Groupe-Mecatronique-Mines-04/Orchestre/Archives/DocumentsGuitarElec/ArchitectureLiaisonsDePilotage_GuitarElec.docx

GuitarElec 2016 : Architecture des liaisons de pilotage des capteurs et actionneurs

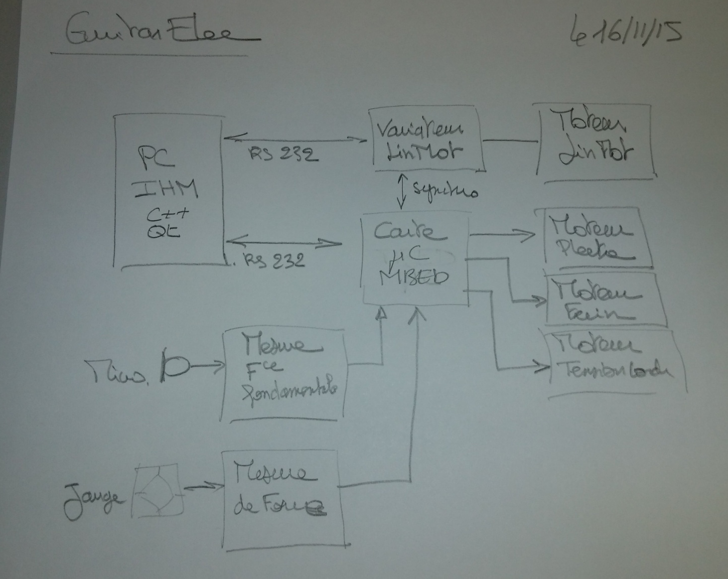
[picture p1: figure]

TAL220 10daN

Synchro ou non ?

?

Tension analogique ?

Micro type « humbucker »

USB/RS232

USB/RS232

Servomoteur Num

Dynamixel AX-12

Servomoteur Num

Dynamixel AX-12

Variateur SyRen10

Motoréducteur Crouset GDR1

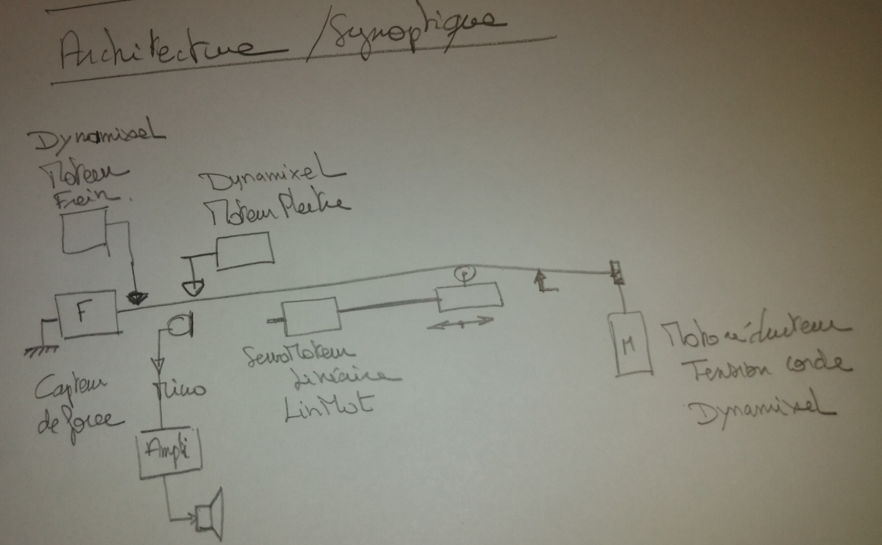
[picture p2: figure]
