Groupe-Mecatronique-Mines-04/Orchestre/Archives/DocumentsGuitarElec/Composants/MoteurLinMot/MoteurDejaAchetÇ.docx

LinMot

Le moteur :

Stator : PS01-37x120-C

Slider : PL01-20x800x720 720 mm est la longueur avec force maxi

Variateur : B1100-GP

Avec logiciel LinRS

Alim 72 volts 300 W

Modèle utilisé par les xMines en septembre, avec la flute, ce modèle sera utilisé au début pour prendre en main la programmation et pilotage du moteur

Stator : PS01-23x80-R

Slider : PL01-12x420x370 370 mm est la longueur avec force maxi

Même variateur, logiciel et alimentation
