Groupe-Mecatronique-Mines-04/Orchestre/Archives/DocumentsGuitarElec/TxEleves/Windchill/synthese mecatro.pptx

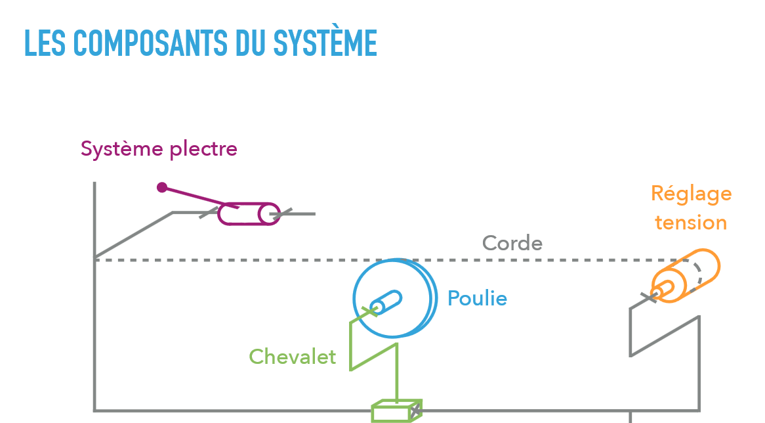
[picture p11: figure]
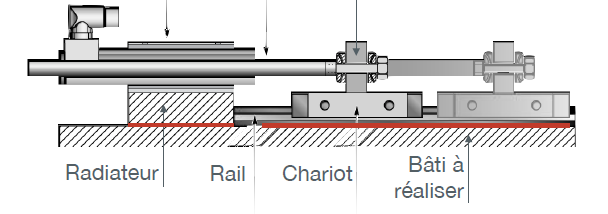
[picture p12: figure]

## Le système plectre

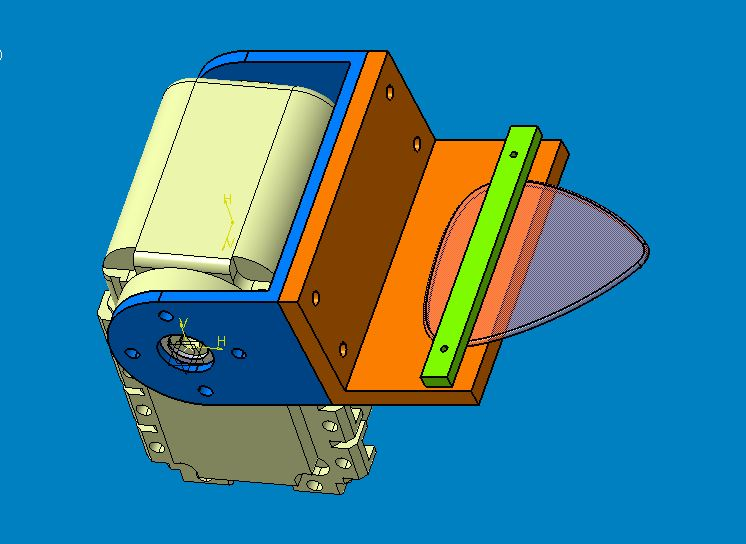
[picture p13: figure]

Plectre en position haute

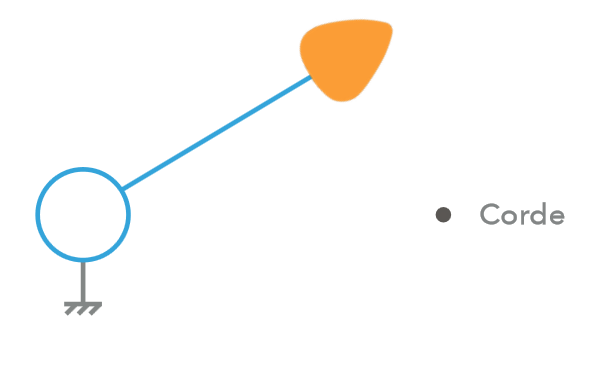
[picture p14: figure]

moteur rotatif

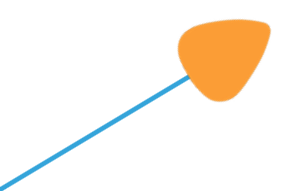
[picture p15: figure]

30 °

Plectre en position basse

Schéma du système plectre

Moteur : servo-moteur AX-12 de Robotis
Angle entre les deux positions du plectre : 30°

Poids (g) | 54.6
Dimensions (mm) | 32x50x40
Voltage (V) | 9
Couple (Nm) | ~ 1.52
Vitesse sans charge (rpm) | 59 ~ 1 tour/sec

## Le moteur linéaire et son guidage

Moteur linéaire : LinMot P01-37x120/580x660
Course max : 66 cm
Force max : 163 N
Vitesse max : 3,2 m/s
Courant : continu, 8,0 A max (72 VDC)
Stator : 21,6 cm, 0,740 kg
Slider : 80 cm, 1,762 kg
Système guidage :
- On fixe le stator au bâti avec le radiateur LinMot PF02-37x100 afin de travailler sur le guidage du moteur.
- La trajectoire du slider et donc le rail conduisant le chariot doivent être parfaitement parallèle au stator.

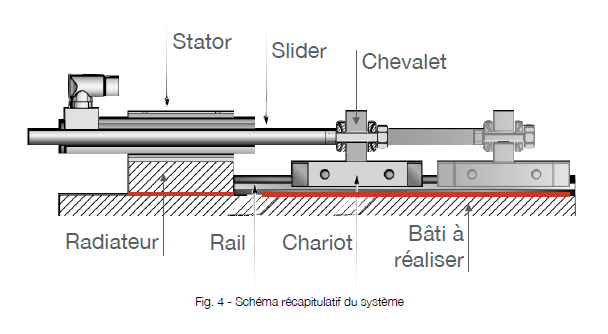
[picture p16: figure]

Schéma du moteur linéaire avec son guidage

## Le chevalet

Poulie

Ressort

Corde guitare

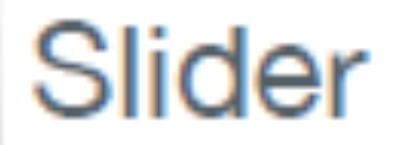
[picture p17: figure]

Il sera fixé au moteur linéaire et bouge linéairement lorsque celui-ci est actionné
Le contact avec la corde se fait par une poulie

## Le système tension de la corde

Utilisation d’une clé de guitare
Moteur : GDR1 courant continu + réducteur
Couple max : 1,2 Nm
Voltage : 12 V
Puissance nominale : 10 W
Vitesse max : 100 tr/min = 1,67 tr/s
Masse : 670 g
Tension à supporter : de l’ordre de 100 N
pour une tension moyenne de 100N, pouvoir la faire varier de 45 à 225 N
Asservissement en tension

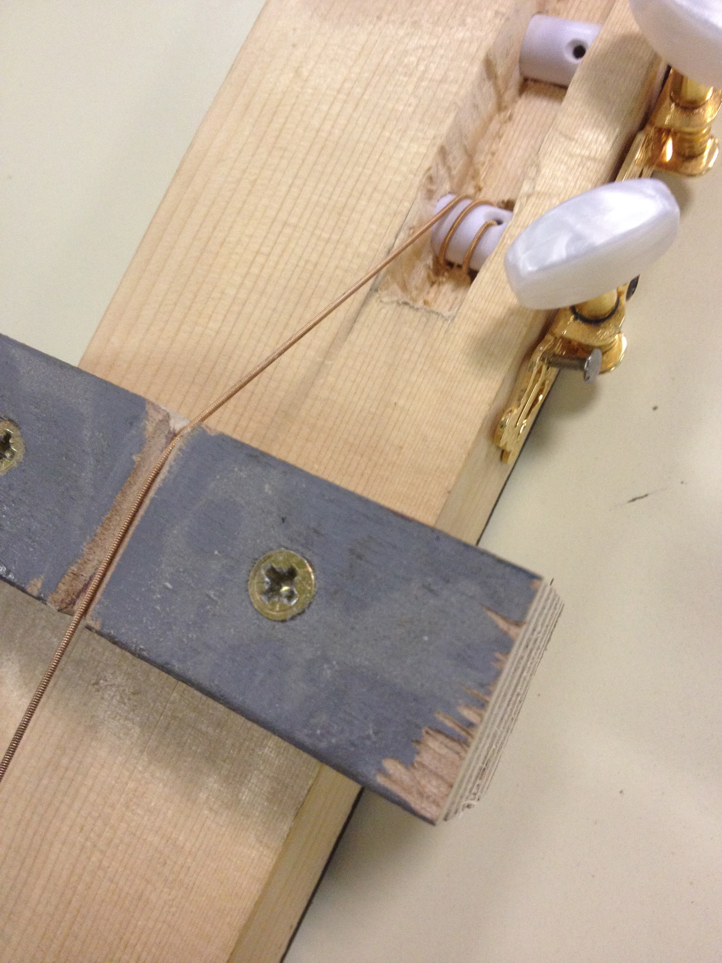
[picture p18: figure]

Le système tension sur la maquette de la guitare

## Les mesures du système

Moteur linéaire : 66 cm de mouvement
Longueur minimale de la corde utile : 10 cm
Longueur maximale : 76 cm

Disposition des différents système par rapport à la corde

Longueur utile de la corde, selon la position du chevalet

Point de fixation de la corde

Point de fixation de la corde

Système plectre

10 cm

Chevalet

Corde

Système Tension

Amplitude du chevalet : 66 cm

10 cm

## Les commandes du système

Un programme informatique doit être écrit pour :
- Créer une interface homme-machine
- A partir des commandes de l’utilisateur, envoyer des commandes aux différents moteurs du système pour exécuter la tâche demandée

Schéma du système électronique retenu de la guitare élec

Légende :

Programme

Commande

Carte Arduino

Moteur linéaire

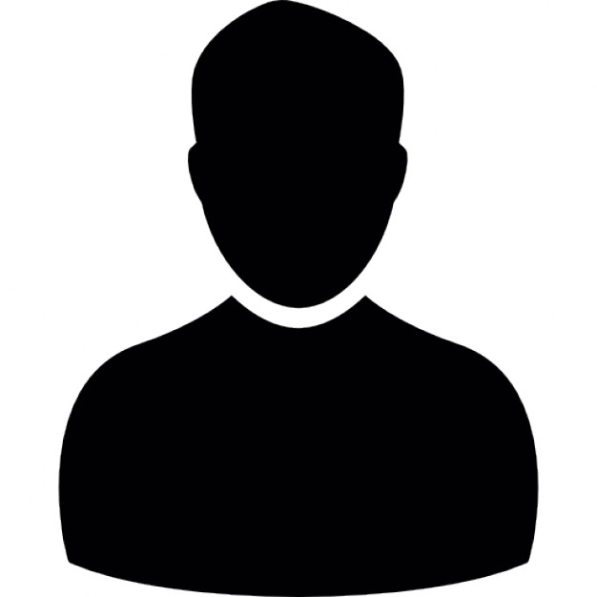
[picture p19: figure]

Moteur tension

Servo-moteur plectre
