Groupe-Mecatronique-Mines-04/Orchestre/Archives/DocumentsGuitarElec/TxEleves/Windchill/Sous-projets/Fixation de la corde/SYSTEME D’ASSERVISSEMENT DE LA CORDE DE GUITARE.docx

# SYSTEME D’ASSERVISSEMENT DE LA CORDE DE GUITARE

## PREMIÈRE ÉBAUCHE DU SYSTÈME

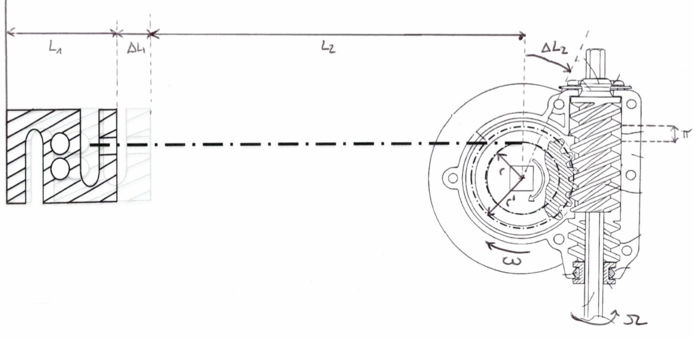
[picture p20: figure]

Motoréducteur et système de mise en tension

Corde de guitare

Capteur et jauge de déformation

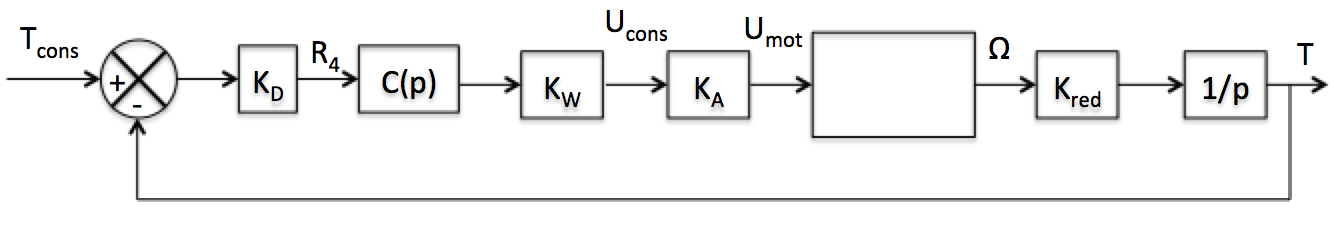
[picture p21: figure]

## MODÈLE D’ASSERVISSEMENT

A/(1+τp)

T

KD : coefficient de déformation de la jauge de déformation

C(p) : correcteur éventuel (dans une deuxième phase)

KW : amplification et filtrage, relation entre composants électroniques

KA : amplification du signal pour atteindre [-12V ;+12V]

On modélise le {moteur+variateur} par un premier ordre.

Kred : réducteur en sortie du moteur + pièce mécanique qui permet d’enrouler la corde

Problème :

1) savoir s’il y a besoin d’une première valeur test pour fixer l’origine des mesures.

2) Relation non linéaire entre la tension de la corde et la fréquence de vibration.

### CALCUL DES COÉfficients

KD : il faut le calculer avec la jauge de déformation achetée :

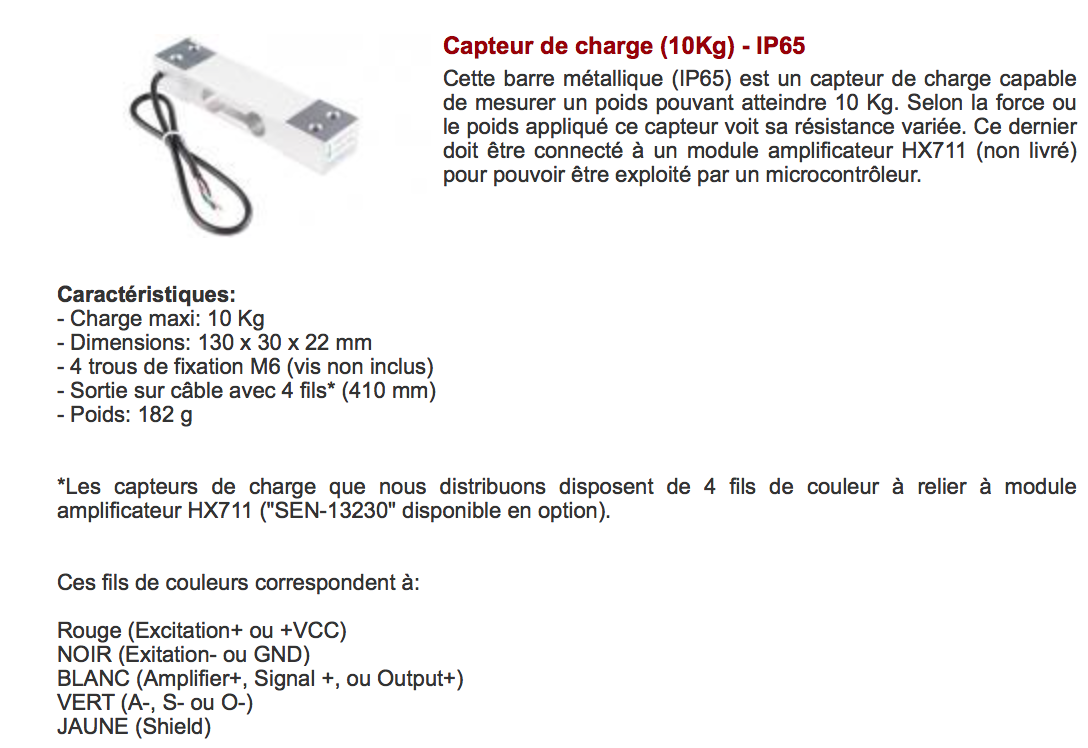
[picture p22: figure]

C(p) : ??? Intégrateur ? Proportionnel ? Dérivé ?

KW et KA : Le calcul se fait à l’aide du schéma électronique suivant :

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
U_3 =-(R_8)/(R_7)U_2 ; U_2 =(-(R_6)/(R_5))/(1+jR_6 Cω)U_1 ; U_1 =(U((R_2 R_4)/(R_2 +R_3)-(R_3)/(R_1 +R_2)))/(R_1 +R_4)

Sans doute plus intelligent de mesurer une tension différentielle et ne pas fixer la masse sur un pont de Weastone.

A et τ : À mesurer une fois qu’on a le moteur

Kred : fourni dans la documentation du moteur

## DIMENSIONNEMENT

On veut jouer environ 3 notes par seconde minimum → f = 3Hz et T=0,33s

L’amplitude de chargement de la corde est de 10kg. On suppose donc que dans le pire des cas on passe de 0kg à 10 kg en 0,33s, la vitesse de chargement est donc vs=30kg/s

Allongement max de la corde : 1cm, la vitesse d’allongement est donc au maximum de 2-3cm/s.
On considère que l’ordre de grandeur du diamètre d’enroulement est 0,5mm donc le périmètre appartient à [12mm ;19mm], il faut donc 1 à 2 tours par seconde. → N∈[60;120] Tr/min

Couple sans frottements en sortie du moteur : environ 100Nx3mm=0,3Nm

Coefficient de sécurité : 2-3 ?

En sortie du moteur, il nous faut une puissance de [10rad/s ;15rad/s]x0,3Nm=[3W-5W]

En supposant un rendement du réducteur d’environ 50%, on dimensionne le moteur à environ

6-10W
