Groupe-Mecatronique-Mines-04/Orchestre/Archives/DocumentsGuitarElec/TxEleves/Windchill/Livrables/01-livrable revue 1/Revue de projet 03_10_2015.pdf

# GUITAR ELEC

# REVUE DE PROJET

Le 03/11/2015

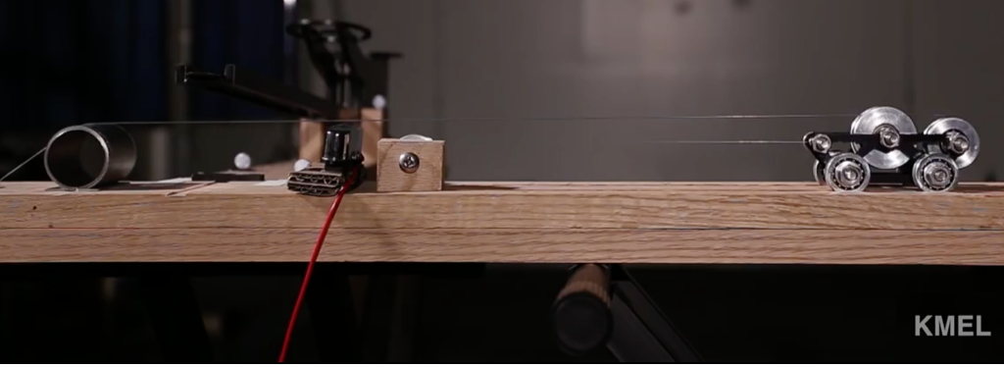
[picture p27: figure]

# LE PROJET KMEL

# L’INSPIRATION

# ANALYSE DU BESOIN

# DIAGRAMME BÊTE À CORNES

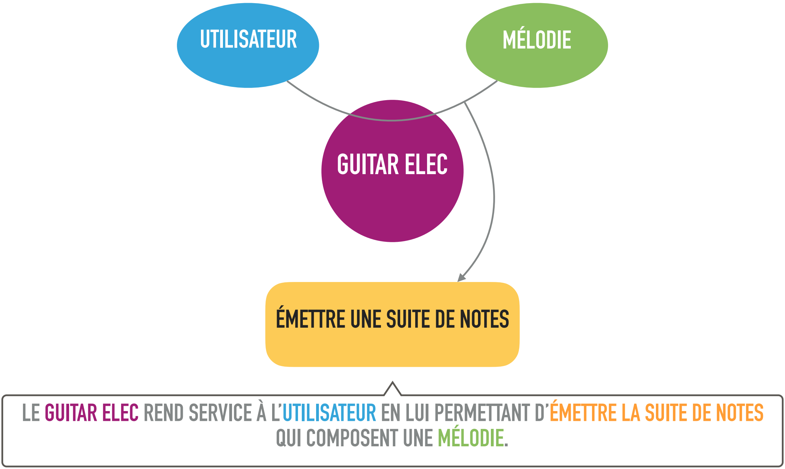
[picture p28: figure]
UTILISATEUR; MÉLODIE; GUITAR ELEC; ÉMETTRE UNE SUITE DE NOTES; QUI COMPOSENT UNE MÉLODIE.

# LE GUITAR ELEC REND SERVICE À L’UTILISATEUR EN LUI PERMETTANT D’ÉMETTRE LA SUITE DE NOTES

# SCHÉMA DU SYSTÈME

# LES COMPOSANTS DU SYSTÈME

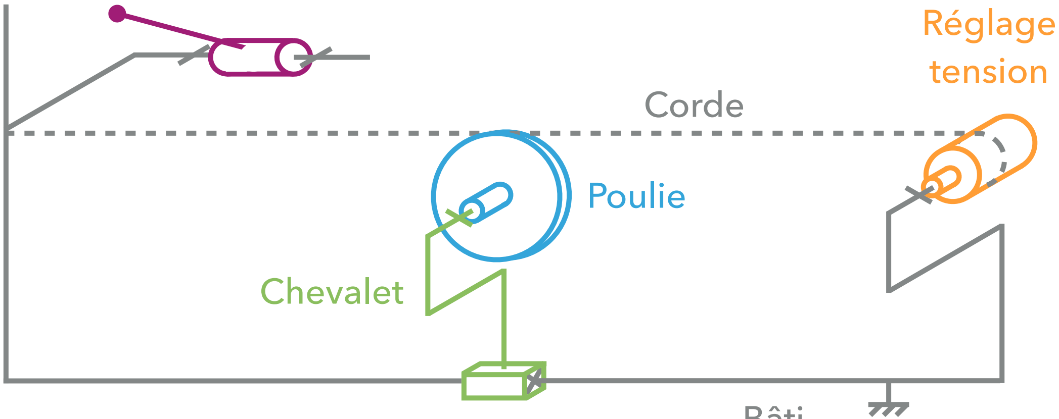
[picture p29: figure]
Corde; Chevalet; Réglage tension; Poulie

# Bâti

# Système plectre

# SCHÉMA DU SYSTÈME

# LES ACTIONNEURS DU SYSTÈME

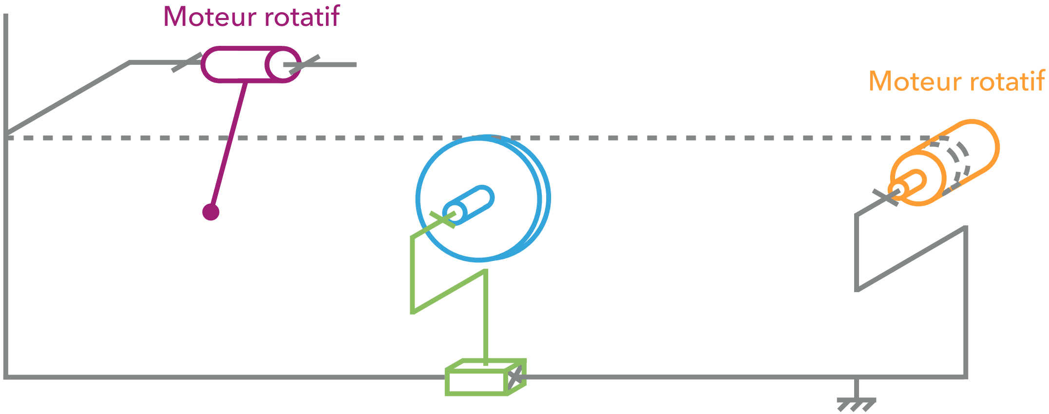
[picture p30: figure]
Moteur rotatif

# Moteur linéaire

# ANALYSE FONCTIONNELLE TECHNIQUE

# CHAÎNE D’INFORMATION ET D’ÉNERGIE

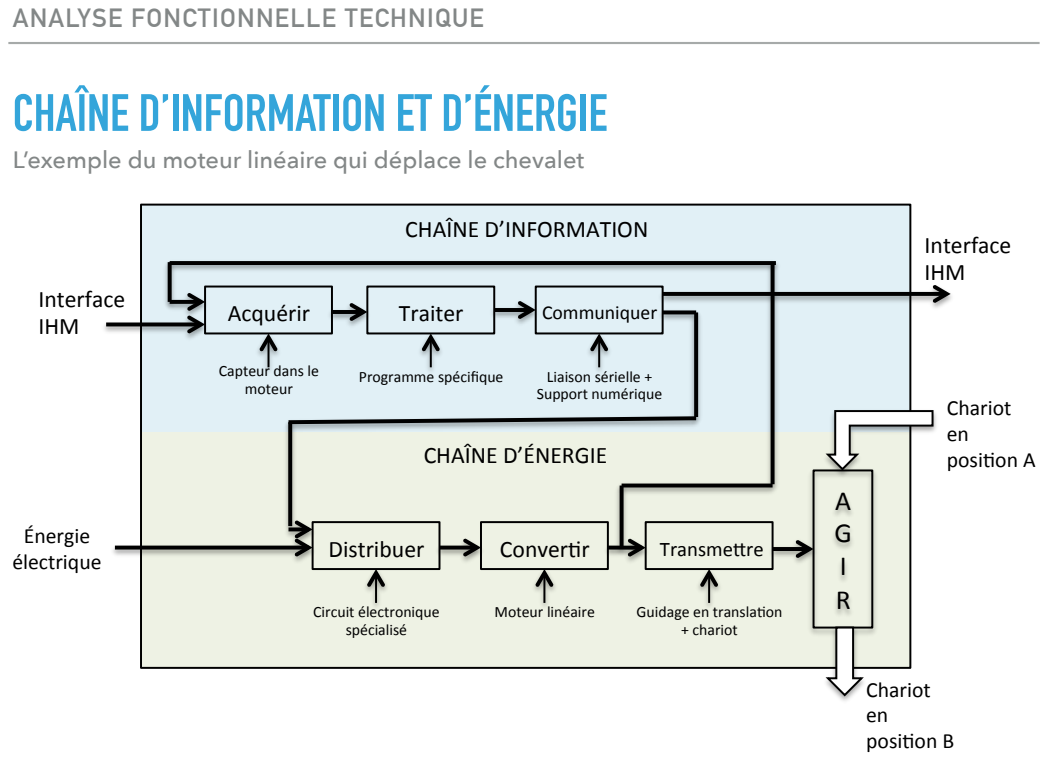
[picture p31: page 6]
Distribuer; Circuit électronique spécialisé; Conver4r; Moteur linéaire; Transme8re; Guidage en transla4on + chariot; Chariot en posi4on A; Chariot en posi4on B; CHAÎNE D’ÉNERGIE; CHAÎNE D’INFORMATION; Énergie électrique; Acquérir; Traiter; Programme spécifique; Communiquer; Liaison sérielle + Support numérique; Interface IHM

L’exemple du moteur linéaire qui déplace le chevalet

Capteur dans le
moteur

# DIAGRAMME FAST

# Permettre à l’utilisateur d’émettre la suite de notes composant une mélodie

FP1

# DIAGRAMME FAST

Permettre à
l’utilisateur
d’émettre la suite
de notes
composant une
mélodie

FP1

## FT11 Recevoir et traiter la commande de l’utilisateur

# Interface Homme Machine

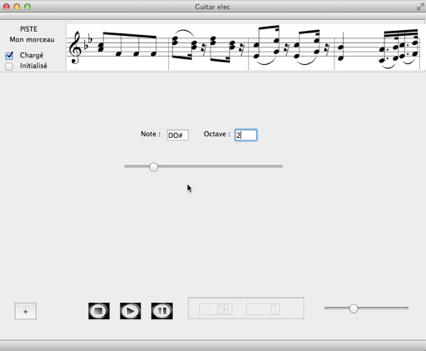
[picture p32: figure]

# DIAGRAMME FAST

Permettre à
l’utilisateur
d’émettre la suite
de notes
composant une
mélodie

FP1

# Interface Homme Machine

# Logiciel

# Optimisation du chemin en tension et déplacement du chevalet entre deux notes

## FT11 Recevoir et traiter la commande de l’utilisateur

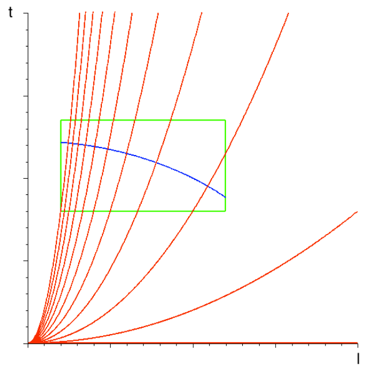
[picture p33: figure]
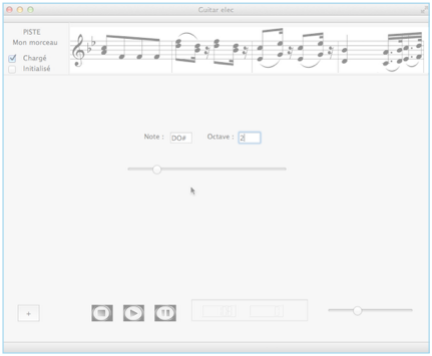
[picture p34: figure]

# DIAGRAMME FAST

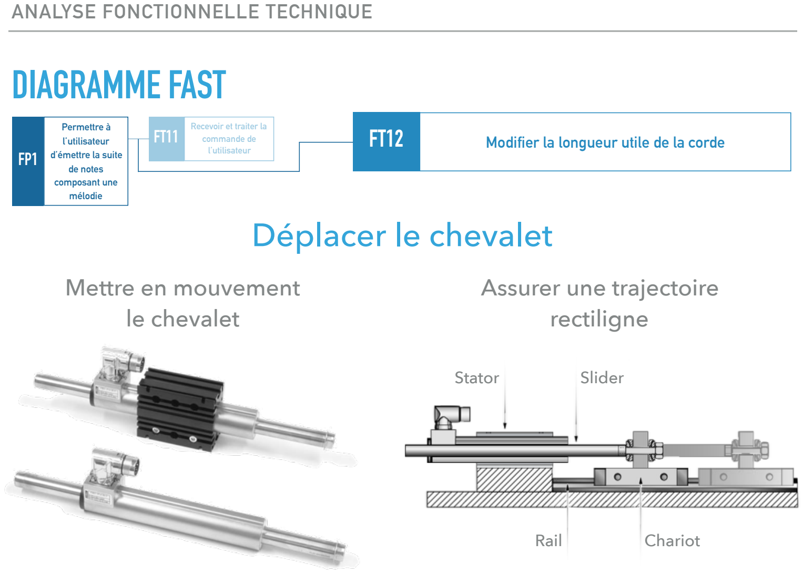
[picture p35: page 10]

Permettre à
l’utilisateur
d’émettre la suite
de notes
composant une
mélodie

FP1

Recevoir et traiter la
commande de
l’utilisateur
FT11 | FT12 | Modifier la longueur utile de la corde

# Déplacer le chevalet

# Mettre en mouvement le chevalet

# Assurer une trajectoire rectiligne

Stator | Slider
Rail | Chariot

# DIAGRAMME FAST

Permettre à
l’utilisateur
d’émettre la suite
de notes
composant une
mélodie

FP1

Recevoir et traiter la
commande de
l’utilisateur
FT11 | FT12 | Modifier la longueur utile de la corde

# Mettre en mouvement le chevalet

# Assurer une trajectoire rectiligne

# Déplacer le chevalet

# Créer un noeud de vibration

# Chevalet

# DIAGRAMME FAST

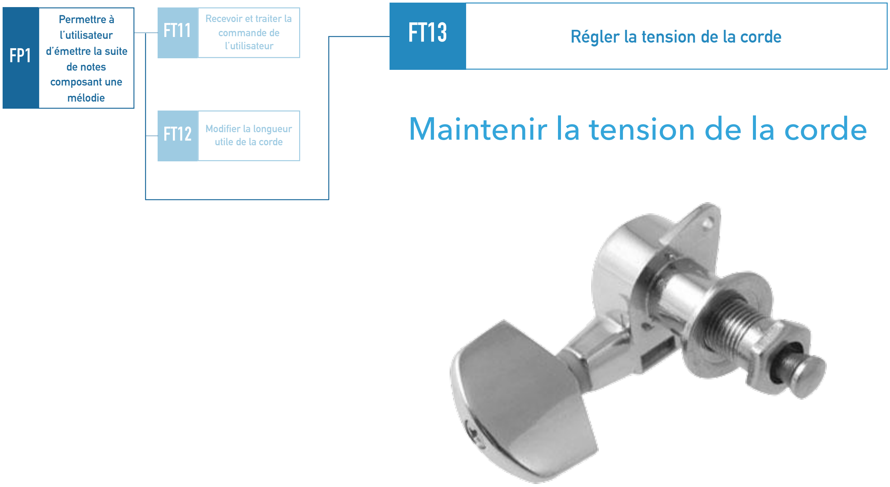
[picture p36: figure]
Permettre à l’utilisateur d’émettre la suite de notes composant une mélodie; Recevoir et traiter la commande de l’utilisateur; Régler la tension de la corde; Modifier la longueur

utile de la corde FT12 | Maintenir la tension de la corde

# DIAGRAMME FAST

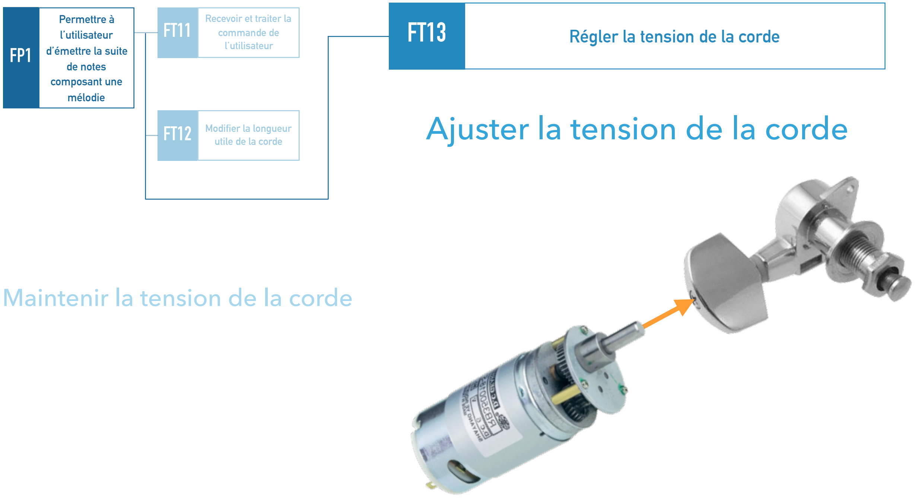
[picture p37: figure]
Permettre à l’utilisateur d’émettre la suite de notes composant une mélodie; Recevoir et traiter la commande de l’utilisateur; Régler la tension de la corde; Modifier la longueur; Maintenir la tension de la corde

utile de la corde FT12 | Ajuster la tension de la corde

# DIAGRAMME FAST

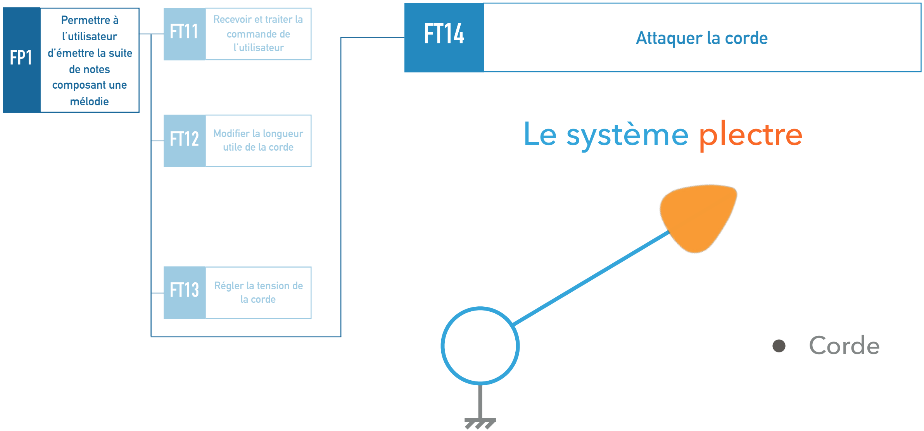
[picture p38: figure]
Attaquer la corde; Le système plectre; Corde; Recevoir et traiter la commande de l’utilisateur; FT11 Permettre à l’utilisateur d’émettre la suite de notes composant une mélodie; Modifier la longueur utile de la corde FT12; Régler la tension de la corde FT13

# DIAGRAMME FAST

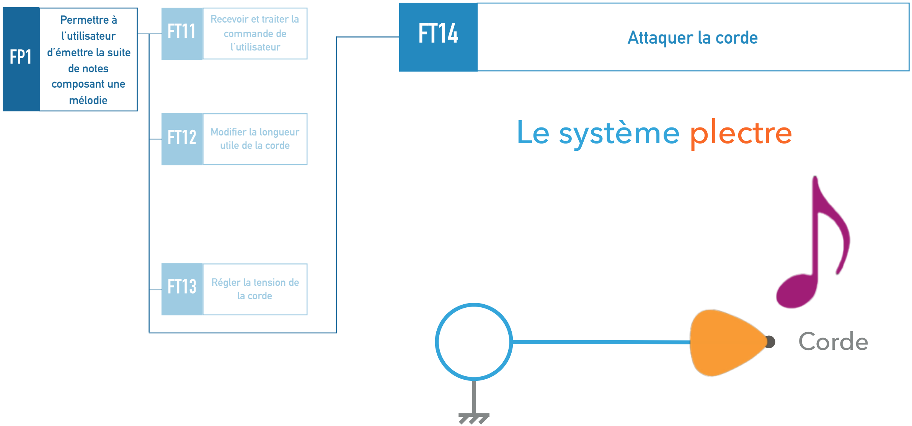
[picture p39: figure]
Permettre à l’utilisateur d’émettre la suite de notes composant une mélodie; Recevoir et traiter la commande de l’utilisateur; Attaquer la corde; Le système plectre; Corde; Modifier la longueur utile de la corde FT12; Régler la tension de la corde FT13

# DIAGRAMME FAST

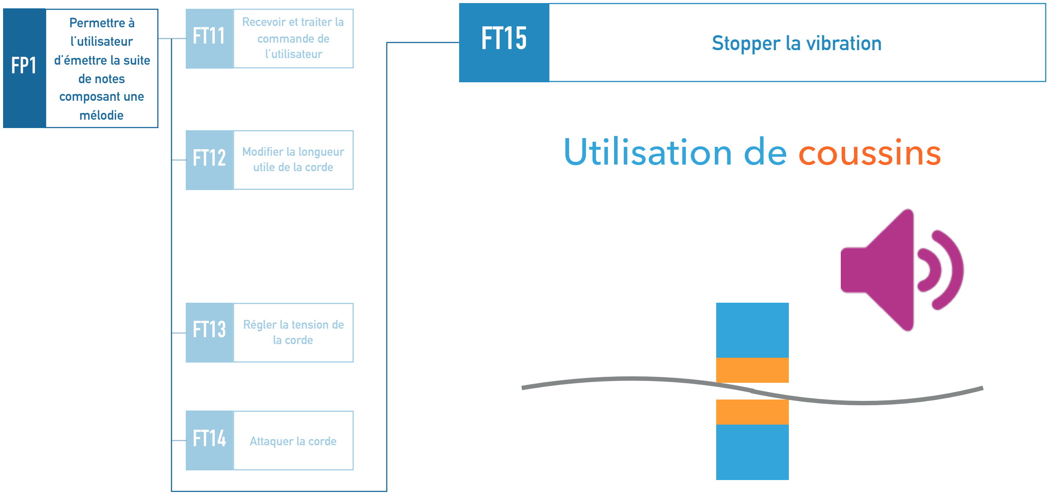
[picture p40: figure]
Permettre à l’utilisateur d’émettre la suite de notes composant une mélodie; Stopper la vibration; Utilisation de coussins; Recevoir et traiter la commande de l’utilisateur; Modifier la longueur utile de la corde FT12; Attaquer la corde; Régler la tension de la corde FT13

# DIAGRAMME FAST

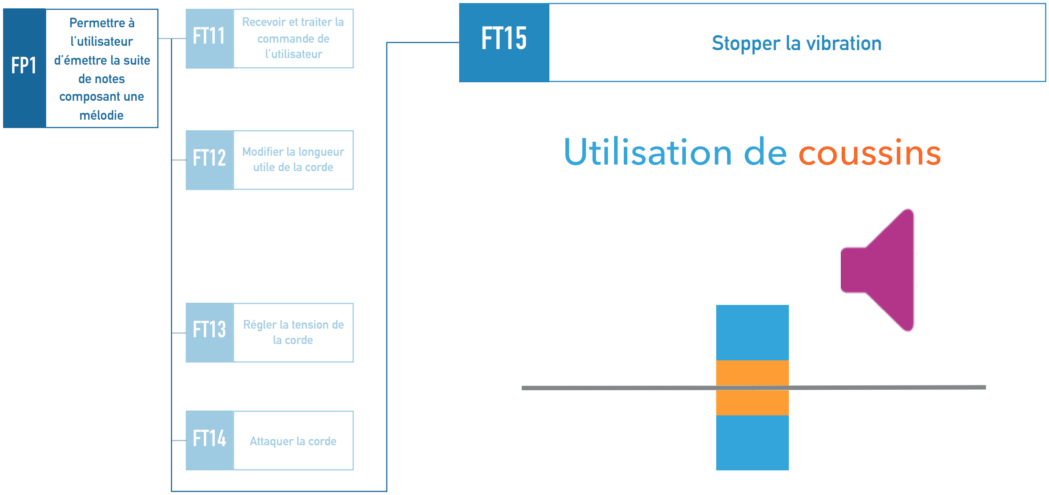
[picture p41: figure]
Permettre à l’utilisateur d’émettre la suite de notes composant une mélodie; Stopper la vibration; Utilisation de coussins; Recevoir et traiter la commande de l’utilisateur; Modifier la longueur utile de la corde FT12; Attaquer la corde; Régler la tension de la corde FT13

# DIAGRAMME FAST

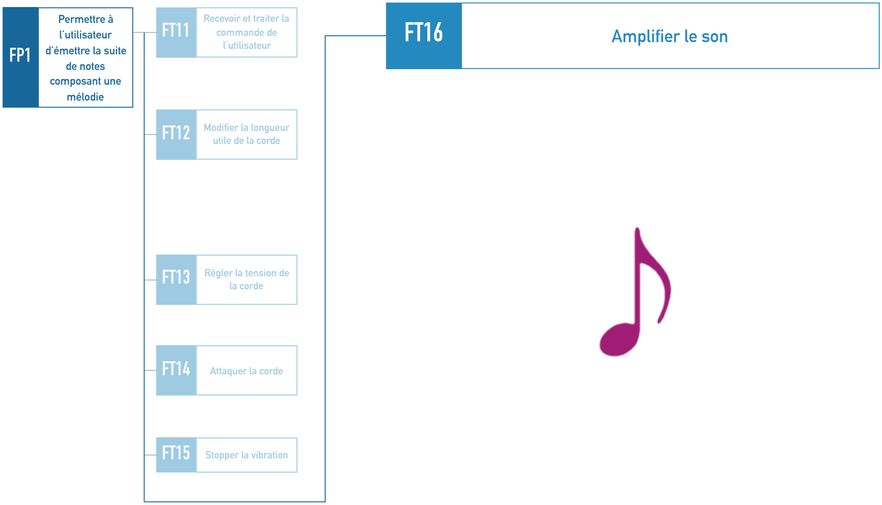
[picture p42: figure]
Permettre à l’utilisateur d’émettre la suite de notes composant une mélodie; Amplifier le son; Recevoir et traiter la commande de l’utilisateur; Modifier la longueur utile de la corde FT12; Attaquer la corde; Stopper la vibration; Régler la tension de la corde FT13

# DIAGRAMME FAST

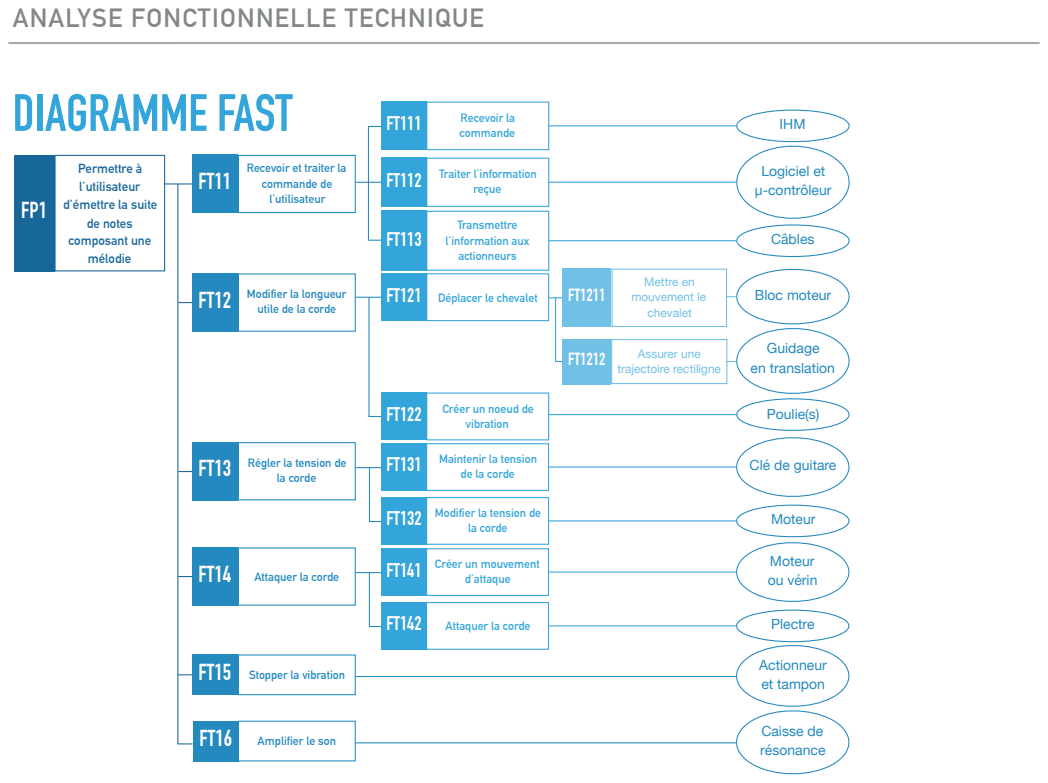
[picture p43: page 19]
Recevoir la commande FT111; Traiter l’information reçue; Transmettre l’information aux actionneurs; Mettre en mouvement le chevalet; vibration FT122; Assurer une trajectoire rectiligne FT1212; IHM; Logiciel et μ-contrôleur; Bloc moteur; Guidage en translation; d’attaque FT141; Attaquer la corde; Moteur ou vérin; Câbles; Poulie(s); Plectre; Actionneur et tampon; Caisse de résonance; Permettre à l’utilisateur d’émettre la suite de notes composant une mélodie; la corde FT132; Moteur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

Recevoir et traiter la

Modifier la longueur

FT121 Déplacer le chevalet

utile de la corde FT12

Créer un noeud de

Maintenir la tension

Régler la tension de

de la corde FT131

Clé de guitare

Modifier la tension de

Créer un mouvement

FT14 Attaquer la corde

FT15 Stopper la vibration

FT16 Amplifier le son

# RÉPARTITION DES TÂCHES

# PLANNING

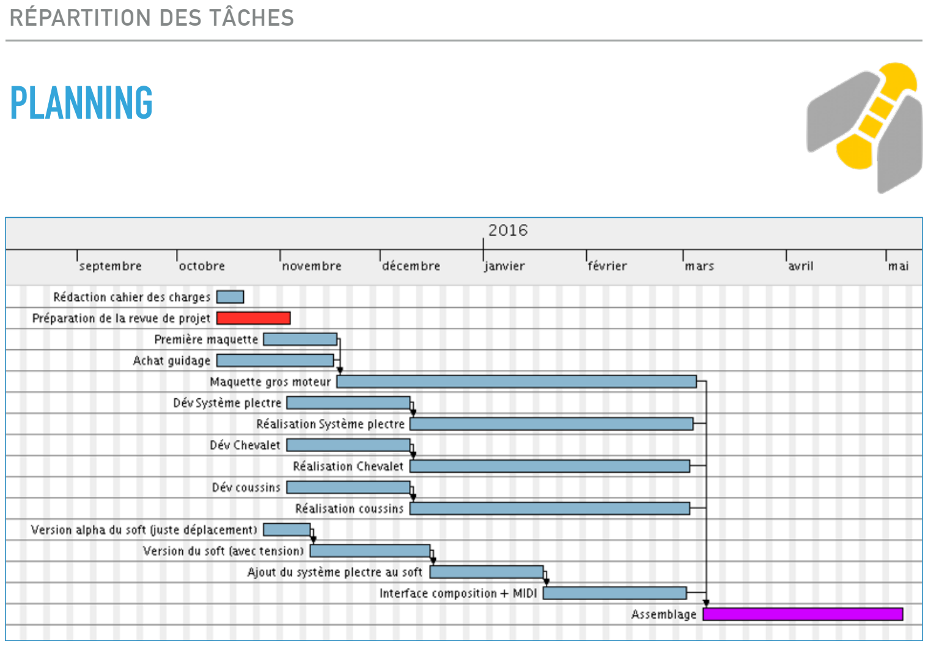
[picture p44: page 20]
