Groupe-Mecatronique-Mines-04/Orchestre/Archives/DocumentsGuitarElec/TxEleves/2016-04-21_Asservissement/AsservissementMoteurTension.docx

Guitar Elec Asservissement moteur 21/04/2016

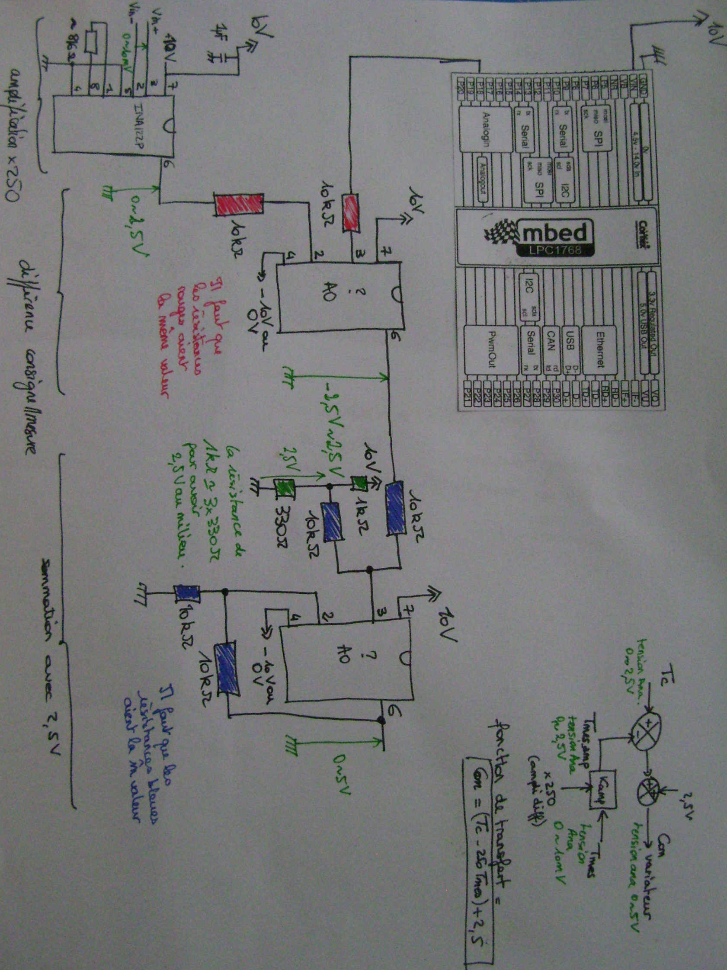
[picture p45: figure]
