Groupe-Mecatronique-Mines-04/Orchestre/Archives/DocumentsGuitarElec/TxEleves/Windchill/Sous-projets/Fixation de la corde/fixation de la corde.docx

Mécatronique

-Groupe 4-

GUITAR ELEC

Etude de la fixation de la corde

# Objectifs :

Le but de cette partie est de trouver la meilleure configuration possible pour :

- fixer la corde de guitare
- permettre une automatisation pour accorder la guitare unicorde
- filtrer dans la bande passante qui nous intéresse
- Assurer une amplitude sonore convenable

# 1. Définition du système.

Le système étudié est constitué des parties mécaniques suivantes :

- La corde de guitare
- Les plaques de fixation qui lient la corde au rail du guidage en translation
- Le système d’automatisation de la tension dans la corde
- Le système de filtration des bruits

Le système peut être résumé par le SADT A0 suivant :

A0

Assurer la MIP

Filtrer le bruit

Corde non fixée

Corde accordée

Trou + système vis écrou

Automatiser la tension dans la corde

Corde mise en place

Assurer le MAP

Corde maintenue en fixation

Plaques

Moteur + vis-écrou

Système de filtration

Bruit non filtré

Bruit filtré

Système de fixation/filtration de la corde

# 2. Modélisation primaire du système : fréquences modales en fonction de la tension dans la corde.

Pour des questions de visibilité, nous noterons les dérivées d’une fonction f par rapport à x : (∂f)/(∂x)(x,t)=f'(x,t) et les dérivées d’une fonction f par rapport au temps : (∂f)/(∂t)(x,t)=f(x,t)

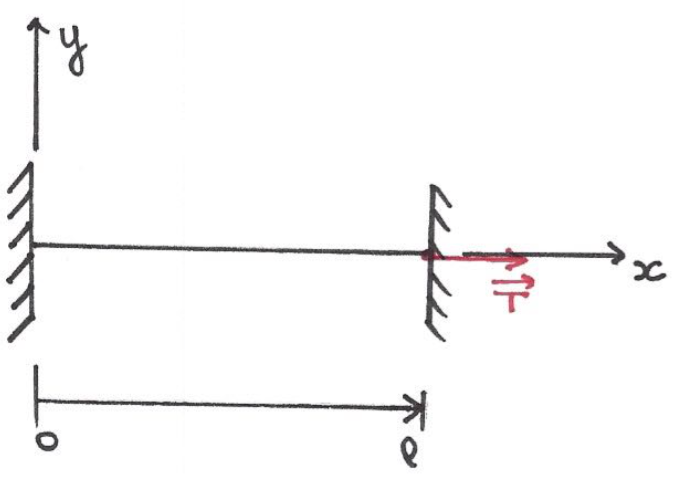
[picture p46: figure]

Modèle de ligne à un degré de liberté.

On étudie une corde de masse linéique m (en kg/m), tendue avec une tension T entre deux points d’attache. On étudie l’équilibre d’un petit élément ∂x. On néglige d’entrée les efforts liés aux contraintes internes. On considère que l’essentiel de la cause de la fréquence de vibration est due à (la longueur et) la tension T appliquée dans la corde.

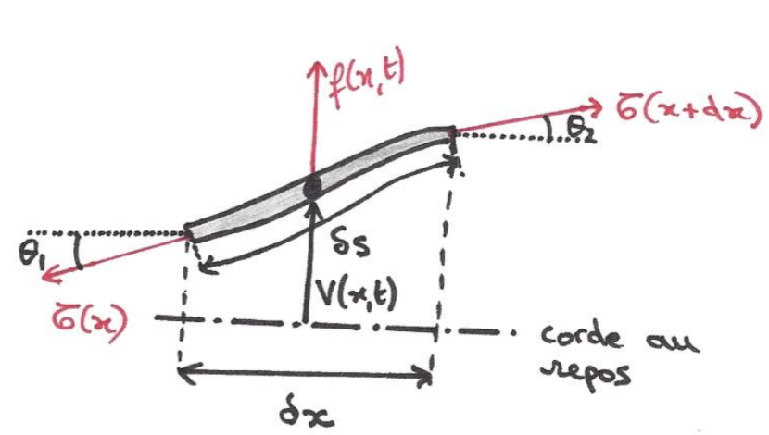
[picture p47: figure]

la résultante des forces selon l’axe y s’écrit :

-T(x)sin(θ_1 )+T(x+dx)sin(θ_2 )+f(x,t)dx=mdx V(x,t)

or la corde est très peu inclinée. L’ordre de grandeur de la longueur de la corde est le mètre, celui des vibrations est au plus du centimètre. On a donc en projetant les forces selon l’axe x :

T(x)sin⁡(θ_1 )≈T(x+dx)cos(θ_2 )→ T(x)≈T(x+dx)≡T

comme les angles θ_1 et θ_2 sont petits, on peut écrire :

sin(θ_1 )≈tan(θ_1 )= V(x,t)

sin(θ_2 )≈tan(θ_2 )= V'(x+dx,t)

Donc :

-T V(x,t)+T V'(x+dx,t)+f(x,t)dx=mdx V(x,t)

soit :

T V''(x,t)+f(x,t)=m V(x,t)

Dans le cas ou on néglige les efforts volumiques f(x,t) on trouve l’équation des cordes :

V^('') -m/TV=0

avec c=√(T/m) la vitesse de propagation des ondes transversales.

On s’intéresse aux vibrations de la corde. Les vibrations sont des ondes transversales stationnaires, les variables de temps et d’espace sont donc découplées et on peut écrire :

V(x,t)=X(x)Y(t)

l’équation des cordes devient alors :

(X'')/X=m/TY/Y=-K^2 on obtient donc deux équations : {, X^('') (x)+K^2 X=0, Y+T/mK^2 Y=0

Les solutions sont donc de la forme : {, X(x)=A sin(Kx)+B cos(Kx), Y(t)=Csin(K√(T/m)t)+Dcos(K√(T/m)t)

Avec les condition initiales : X(0)=X(L)=0→B=0 et K=(nπ)/L avec n le mode.

On a donc X_n (x)=A_n sin⁡((nπx)/L) avec An une constante arbitraire

Il y a donc aussi un nombre infini d’équations différentielles

Y+T/mK_n ^2 Y=0 donc les solutions sont : Y_n (t)=C_n sin(K_n √(T/m)t)+D_n cos(K_n √(T/m)t)

Les solutions de déplacement et de la vitesse de la corde s’expriment donc à partir de la somme sur n du produit des fonctions Y_n (t)X_n (x)

Et V(x,t)=∑_(n=1)^(∞) (C_n sin((nπ)/L√(T/m)t)+D_n cos((nπ)/L√(T/m)t))A_n sin((nπ)/Lx) où ω_n =K_n c=(nπ)/L√(T/m)

Cahier des charges :

temps d’asservissement << temps où on joue la mélodie

On ne s’intéresse pas au déphasage lors des vibrations, on étudiera donc la fonction :

V(x,t)=∑_(n=1)^(∞) V_n sin((nπ)/L√(T/m)t)sin((nπ)/Lx)

# 3. Système d’asservissement de la corde

Afin d’assurer la précision nécessaire, nous choisissons d’asservir en tension la corde plutôt qu’en position relative.

2 solutions s’offrent à nous :

1) D’un côté, nous fixons la corde à une jauge de déformation pour remonter, grâce aux relations contraintes/déformations à la tension T. De l’autre côté, la corde est fixée à un écrou.

On fait translater l’écrou grâce à un système écrou et vis sans fin.

Avantage : Peu de pièces en mouvement, bonne dynamique

Inconvénients : encombrant axialement, précision moyenne de position axiale.

Condition d’irréversibilité :

B | 0° 90°- 90° ϕ ϕ
couple moteur | réversible | réversible | irréversible
effort moteur | irréversible | réversible | réversible

Avec B l’angle d’inclinaison du filet ( tan(B)=(pas)/(2π))

F’ le coefficient de frottement apparent avec f^(') =tan(ϕ)=(tan⁡(φ))/(cos⁡(γ)) avec f=tan⁡(φ) le frottement réel et γ l’angle d’inclinaison de la surface de contact

Le système doit être irréversible (un effort axial n’entraine pas de rotation) → on doit se trouver dans la première colonne du tableau ( B∈[ϕ;90°-ϕ] )

2) Nous gardons la même configuration à gauche avec la jauge de déformation, en revanche à droite, on remplace le système vis écrou par un système roue et vis sans fin. Avantage : moins encombrant axialement, on peu déporter le pièces sur un côté (derrière), précision qui peut être très élevée (dépend du jeu dans les liaisons), peu de pièces en mouvement

Inconvénient : Dynamique en peu plus lente (rapport de réduction très élevé)

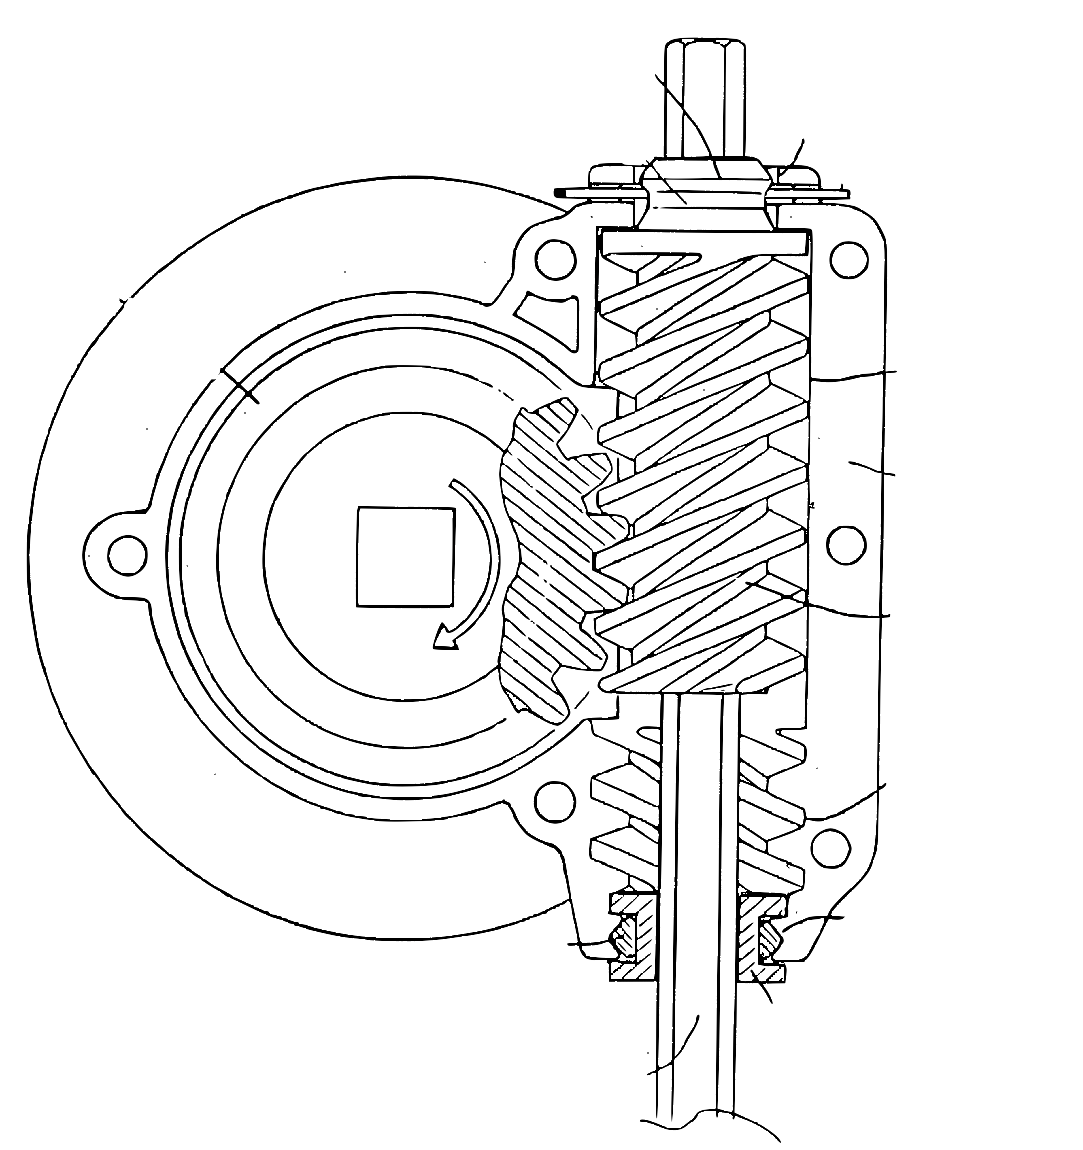
[picture p48: figure]

Nous nous orientons vers la deuxième solution technique.

On utilise le schéma suivant pour décrire le comportement du système à savoir :

(dT)/(dt)=f(ω)

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
On note K le coefficient de raideur de la jauge de déformation.

On a les relations suivantes :

{, X=p/(2π)α soit X=p/(2π)ωX=ρθ, T-T_0 =K.δL_1 T-T_0 =σS=εES=ES(∆L_2)/(L_2)=ES(R∆θ)/(L_2)

D’où :

T=(ESRp)/(2πL_2 ρ)ω=KL_1

[Tapez le texte][Tapez le texte][Tapez le texte]

1 13.10.2015Fixation de la corde

MécatroniqueSolène de Percin Tommy Kopp
