Groupe-Mecatronique-Mines-04/Orchestre/Archives/DocumentsGuitarElec/trombi mÇcatro 4_DB.pdf

Trombinoscrope groupe mécatronique 4 – la corde de guitare

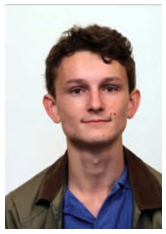
[picture p49: figure]
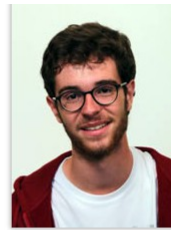
[picture p50: figure]
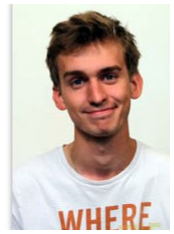
[picture p51: figure]

Benoît de Malet

Cyprien
d'Harcourt

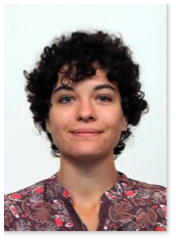
[picture p52: figure]

Serena
Delgado

Paul Jennepin

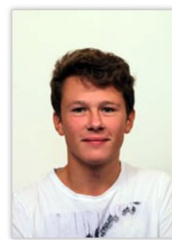
[picture p53: figure]
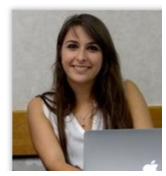
[picture p54: figure]

Roxane Laigle

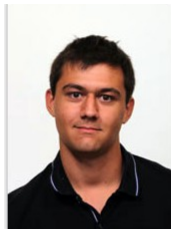
[picture p55: figure]

Tommy Kopp

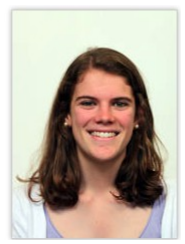
[picture p56: figure]

Solène de
Percin

Thibault Alexandre

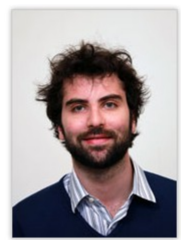
[picture p57: figure]

Jean-Charles
Lévy

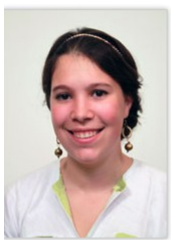
[picture p58: figure]

Capucine
Mommeja
