Groupe-Mecatronique-Mines-04/Orchestre/Archives/DocumentsGuitarElec/TxEleves/Windchill/Com generale/trombi mÇcatro 4.pdf

Trombinoscrope groupe mécatronique 4 – la corde de guitare


Benoît de Malet

Cyprien
d'Harcourt


Serena
Delgado

Paul Jennepin


Roxane Laigle


Tommy Kopp


Solène de
Percin

Thibault Alexandre


Jean-Charles
Lévy


Capucine
Mommeja
