Groupe-Mecatronique-Mines-04/Orchestre/Archives/DocumentsGuitarElec/TxEleves/2015-11-10/BTS - Solutions Plectre.pdf

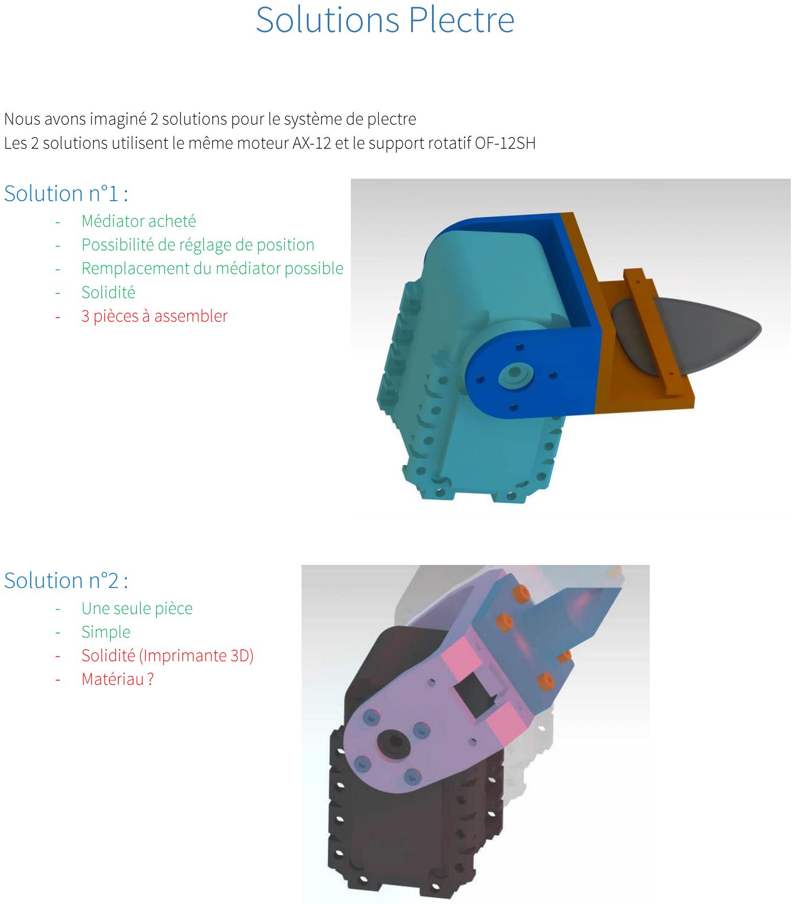
[picture p63: page 1]
