Groupe-Mecatronique-Mines-04/Orchestre/Archives/DocumentsGuitarElec/TxEleves/2015-11-10/LTL.pdf

# Mécatronique

# Optimisation du changement de fréquence

Groupe 4 : Guitar elec

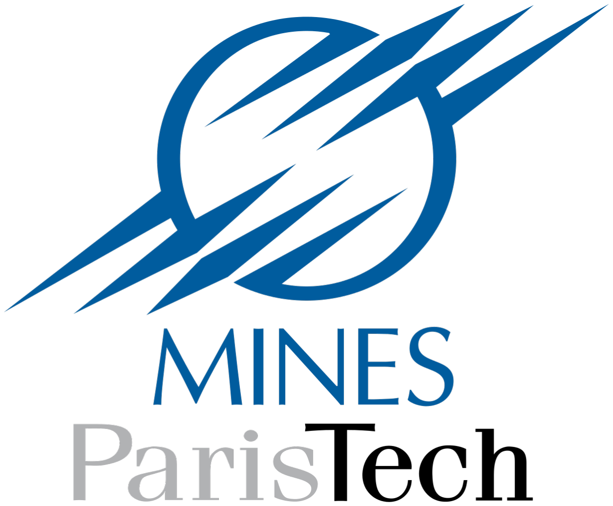
[picture p64: figure]

# Mines ParisTech Octobre 2015

## Table des matières

1 Position du problème | 2
1.1 Etats et commandes du système | ´ | 2
2 Réponse au problème | 4

## 1 Position du problème

### 1.1 Etats et commandes du système ´

Le système guitar-elec a la possibilité de faire varier à la fois la tension et la longueur utile de la corde vibrante. Afin d’optimiser le fonctionnement du système, nous nous sommes posés la question : quel est le chemin de variation de longueur et de tension qui minimise le temps entre deux notes ?

Cette question pose un problème mal défini. Notre système possède deux commandes et trois états. Les trois états sont la longueur de la corde, sa tension et sa fréquence. Les commandes sont les deux moteurs portant sur la modification de la tension et de la longueur de la corde. Nous ne connaissons pas bien la dynamique que suivent les moteurs contrôlant la tension et la longueur. Si L

∗
et T

∗
sont les valeurs finales sur lesquelles sont asservis les moteurs, on notera, en toute généralité :

dL
dt = u(L

∗
, L)

dT
dt = v(T

∗
, T)

où u, v sont des fonctions vérifiant de bonnes propriétés pour que le système, initialement en (L, T) converge vers (L

∗

, T∗
).

Nous savons que la fréquence de la corde vibrante est donnée par la formule :

f =

1
2L

s
T
µ

(1)

Cela permet de réduire le nombre d’état de notre système à seulement deux : L et T. On constate que la tension dépend quadratiquement de la longueur à fréquence constante.

T = 4µf ²L

2

Ce que l’on peut représenter par le graphique :

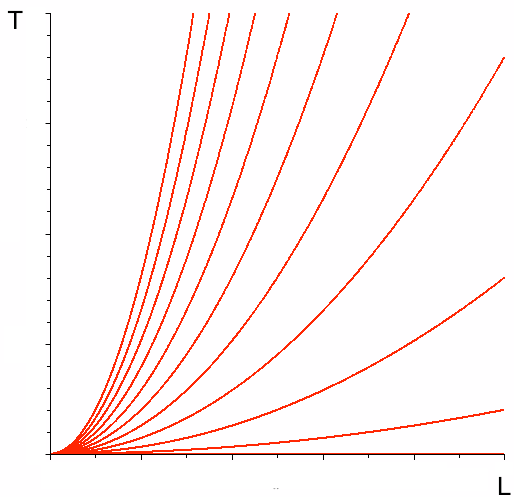
[picture p65: figure]

Figure 1 – Lignes de niveau de la fréquence dans l’espace (L, T), unités arbitraires

### 1.2 Définition du problème

Par ce qui précède, on comprend que l’optimisation à réaliser est en deux étapes.

Premièrement l’asservissement en longueur et en tension est assuré par les moteurs. Le moteur pour la longueur est un servomoteur linéaire LinMot dont on peut paramétrer la vitesse maximale, l’accélération et la décélération. Le moteur pour la tension est également un servomoteur paramétrable.

Deuxièmement, l’état final (L

∗

, T∗
) à passer en argument aux moteurs pour qu’ils réalisent l’asservissement doit être tel que le changement de fréquence est optimal. Avec les notations, si le changement de fréquence correspond au passage de f1 = f(L, T) à f2, il faut trouver (L

∗

, T∗
)
minimisant la distance entre (L, T) et (L

∗

, T∗
) sous la contrainte f(L

∗

, T∗
) = f2. Cependant
cette contrainte ne suffit pas. On veut que notre système soit réversible. C’est à dire que partant de f2 = f(L

∗

, T∗
) et voulant aller en f1, il faut que le résultat de l’optimisation soit (L, T). On revient sur nos pas.

On s’intéressera seulement au second problème (le premier étant de l’asservissement). Ainsi on recherche un chemin, ie une fonction F vérifiant :

F(f) =
L

∗
T

∗

nous donnant l’argument (L

∗

, T∗
) à passer aux moteurs à partir de la fréquence souhaitée.

## 2 Réponse au problème

### 2.1 Dynamique du système

### 2.1.1 Rejet de la dynamique

La longueur et la tension suivent une certaine dynamique que l’on peut représenter par deux classes de fonctions du temps (t → vL∗ (t))L∗ et (t → vT ∗ (t))T ∗ représentant la vitesse de variation de L et T lorsque (L

∗

, T∗
) est l’état final et (0, 0) l’état initial. Ces classes de fonctions vérifient :
Z +∞

0

vL(t)dt = L
Z +∞

0

vT (t)dt = T

Elles sont nulles à partir d’un certain temps, que l’on notera τL et τT . On a alors :

# Z τL

0

vL(t)dt = L

# Z τT

0

vT (t)dt = T

On a fait des hypothèses d’invariance par translation et par symétrie, c’est-à-dire que le temps pour passer de (L, T) à (L

∗

, T∗
) est le même que celui pour passer de (0, 0) à (|L

∗−L|, [T

∗−T|).
On peut alors définir une distance :

d((L, T),(L

∗

, T∗
)) = max(τ|L∗−L|

, τ|T ∗−T|)

La prise en compte de la dynamique du système pose le problème sous la forme :

Partant de f1 = f(L, T), trouver (L

∗

, T∗
) qui minimise d((L, T),(L

∗

, T∗
)) sous la contrainte
f(L

∗

, T∗
) = f2.

Cette formulation du problème ne prend pas en compte la notion de reversibilité que nous souhaitions et elle ne pourra jamais la prendre en compte. Faisant une distinction entre les fréquences proches et les fréquences éloignées, la prise en compte de la dynamique ne peut pas fournir un unique chemin ne dépendant pas de la grandeur |f2 − f1|. C’est pourquoi nous rejetons la prise en compte de la dynamique du système dans notre optimisation.

### 2.1.2 Prise en compte des vitesses moyennes

Cependant il faut bien rendre compte des vitesses de variation de la longueur et de la tension, on note t =

T
vT

et l =

L
vL

où vT et vL sont respectivement la vitesse moyenne de variation de la tension et la vitesse moyenne de variation de la longueur. Cela revient à définir une distance :

d((L, T),(L

∗

, T∗

)) = s
(L∗ − L)
2
v

2
L

+

(T

∗ − T)
2
v

2
T

Ainsi t et l sont des durées. On pose également λ = f

2
. On a ainsi

t = 4

vL

2
vT

µλl²
(2)

Les lignes de niveau de λ dans l’espace (l, t) ont la même forme que celles de la figure 1.

### 2.2 Graphiquement

Le chemin le plus court dans l’espace (l, t) pour passer d’une valeur λ1 correspondant à (l, t) à une autre valeur λ2 est une droite orthogonale à la courbe λ = λ2 et passant par (l, t). Cependant cette solution ne prend pas en compte la réversibilité évoquée plus haut. La solution pour intégrer cette reversibilité dans notre problème est de considérer des valeurs de λ infiniment proches. C’est à dire entre λ et λ+dλ. La droite se transforme alors en une courbe orthogonale au faisceau de lignes de niveaux tracé sur la figure 1.

On attend alors une courbe de la même forme que la courbe en bleu représentée sur la figure
2. Bien évidemment cette courbe doit vivre dans un espace de la forme [lmin, lmax]×[tmin, tmax].

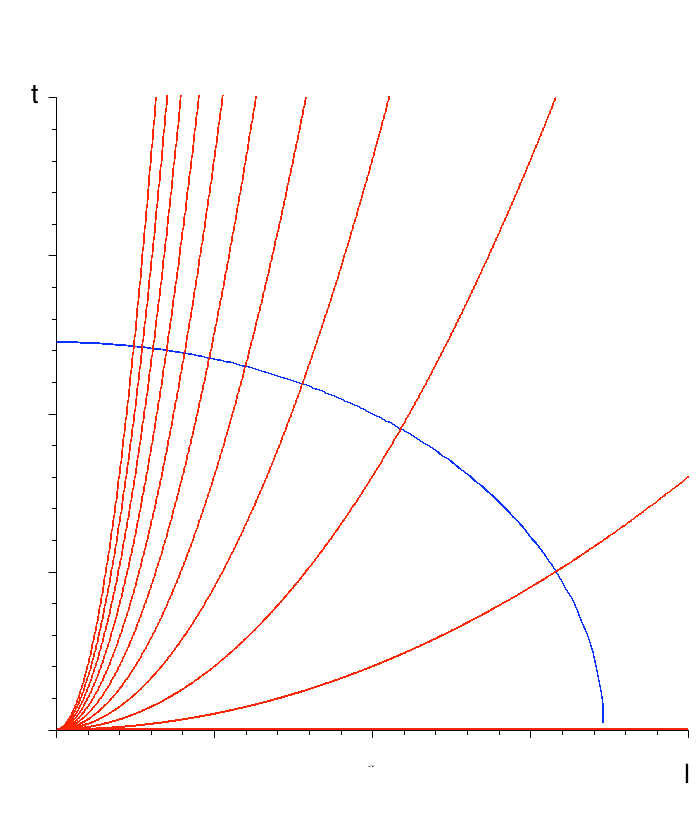
[picture p66: figure]

Figure 2 – Lignes de niveau de la fréquence dans l’espace (l, t) (en rouge) et chemin le plus court (en bleu), unités de temps arbitraires

### 2.3 Mathématiquement

Notons Cλ l’ensemble des lignes de niveau dépendant du paramètre λ.

Cλ = {M(s, λ) = (s, 4

vL

2
vT

µλs²
), s ≥ 0}

On cherche une courbe M(s, λ(s)) orthogonale à toutes les courbes Cλ. Le vecteur directeur de Cλ s’exprime :
−−→∂M
∂s =
1
8

vL

2
vT

µλs

Le vecteur directeur de la courbe recherchée M(s, λ(s)) s’exprime : −−→∂M
∂s + λ

(s)

−−→∂M
∂λ =
1

vL
vT

µλs + 4λ

(s)

vL
vT

µs²

La condition d’orthogonalité s’exprime : −−→∂M
∂s ·

−−→∂M
∂s + λ

0
(s)

−−→∂M

∂λ

= 0

1 + 64

vL

4
vT

2

µ

2λ(s)

2
s

2 + 64

vL

4
vT

2

µ

2λ(s)s

3 = 0

En posant u(s) = λ(s)

2
et α = 4 vL

2
vT

µ, l’équation devient :

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
Cette équation du premier ordre se résout en :

u(s) = C
s

4

−

1
2α²s

2
avec C une constante positive. En effet si C < 0 alors u < 0 pour s ≥ 0, ce qui implique l’absurdité λ

2 < 0.
Finalement,
λ(s) = r
C
s

4

−

1
2α²s

2

=

1
αs²

r
α²C −

s

2
2
et

M(s, λ(s)) =
q

s

α²C −

s

2
2

!
avec α = 4

vL

2
vT
µ | (3)

En fonction de la fréquence les équations deviennent :

L(f) = vL

p
2(α²C − f

4
) | (4)
T(f) = 2vTαf ²
(α

2C − f

4
) | (5)

Reste à déterminer C. C’est ce que font les conditions aux limites.

### 2.4 Conditions aux limites

Les conditions aux limites s’expriment :

Cas 1 : λmin =

tmin
αl²
max
Cas 2 : λmax =

tmax
αl²
min
Ce qui devient

1
αl²
max

r
α²C1 −

l

2
max
2

=

tmin
αl²
max
1
αl²
min

r
α²C2 −

l

2
min
2

=

tmax
αl²
min
On exprime alors la constante C dans les deux cas :

C1 =

1
α²

(t

2
min +

l

2
max
2

)

C2 =
α²

(t
max +

l

2
min
)

Si la condition C1 = C2 n’est pas vérifiée, la solution trouvée précédemment ne peut pas atteindre les deux extrémités de la portion de l’espace [lmin, lmax] × [tmin, tmax]. On note λ1, λ2 les solutions obtenues avec respectivement C1 et C2 :

1er cas

Si C1 > C2 alors

λ1(lmin) > λ2(lmin) = λmax

et

λ2(lmax) < λ1(lmax) = λmin

Que l’on choisisse C1 ou C2, la solution sort du pavé [lmin, lmax] × [tmin, tmax].

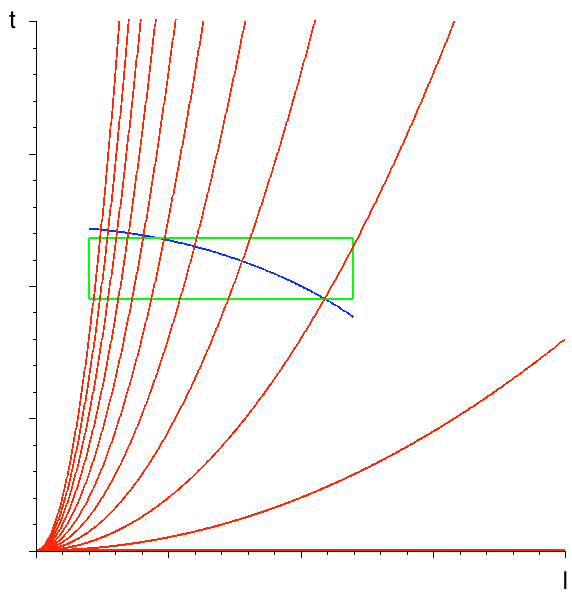
[picture p67: figure]

Figure 3 – Schématisation du cas 1. En rouge les lignes de niveaux, en bleu la solution et en vert les limites du système

2ème cas

Si C1 < C2 alors

λ1(lmin) < λ2(lmin) = λmax

et

λ2(lmax) > λ1(lmax) = λmin

Que l’on choisisse C1 ou C2, la solution n’atteint pas les valeurs limites de l’intervalle [λmin, λmax].

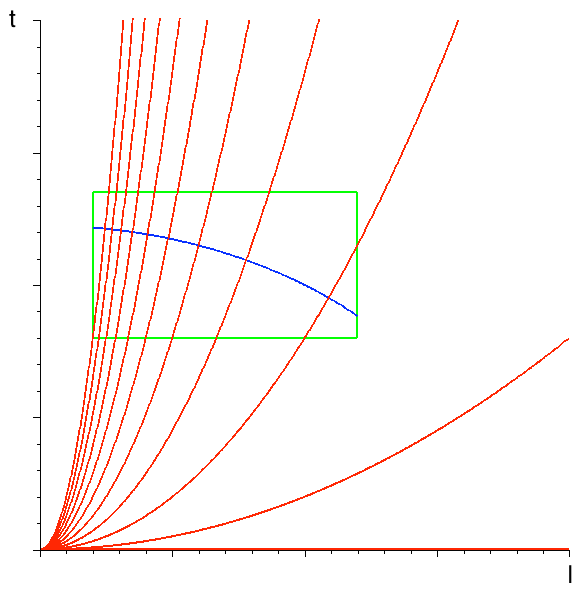
[picture p68: figure]

Figure 4 – Schématisation du cas 2. En rouge les lignes de niveaux, en bleu la solution et en vert les limites du système

3ème cas

Le 3ème cas, idéal mais complètement irréaliste correspond à C1 = C2. On a alors

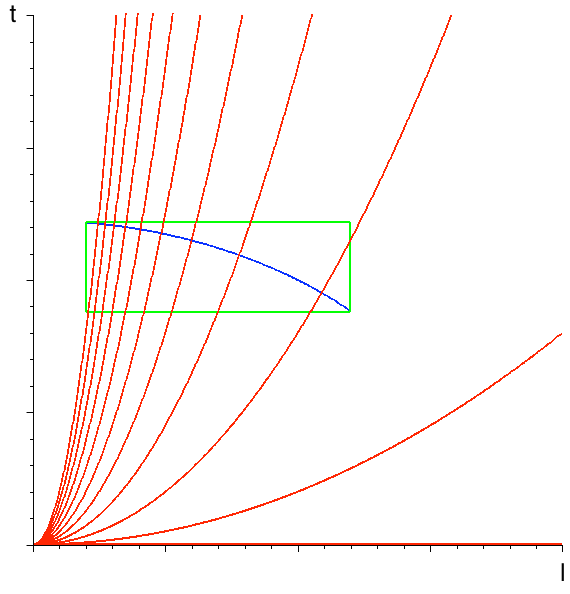
[picture p69: figure]

Figure 5 – Schématisation du cas 3. En rouge les lignes de niveaux, en bleu la solution et en vert les limites du système
