Groupe-Mecatronique-Mines-04/Orchestre/Archives/DocumentsGuitarElec/TxEleves/Windchill/Sous-projets/Chaine d'+�nergie et d'information/chaine d'energie-info.pdf

A

## Chariot

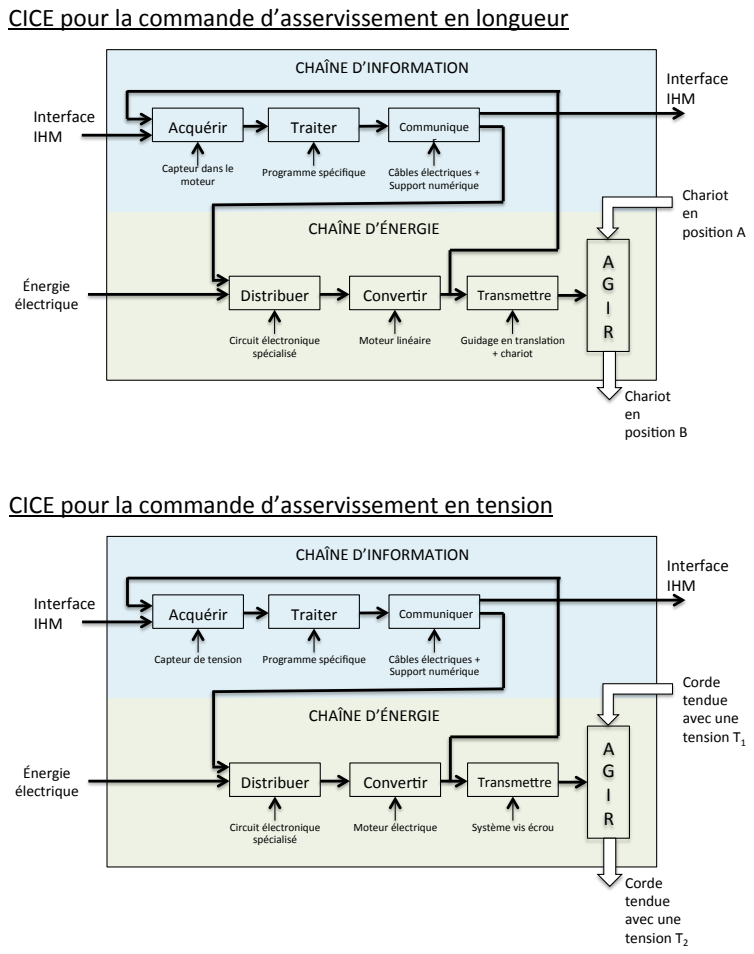
[picture p81: page 1]
Distribuer; Circuit électronique spécialisé; Conver4r; Moteur linéaire; Transme8re; Guidage en transla4on + chariot; en posi4on A; Chariot en posi4on B; CHAÎNE D’ÉNERGIE; CHAÎNE D’INFORMATION; Énergie électrique; Acquérir; Traiter; Programme spécifique; Communique r; Câbles électriques + Support numérique; Interface IHM; Moteur électrique; Corde tendue avec une tension T1; Corde tendue avec une tension T2; Communiquer

CICE pour la commande d’asservissement en longueur

Capteur dans le
moteur

CICE pour la commande d’asservissement en tension

Capteur de tension

Système vis écrou

A

## Corde

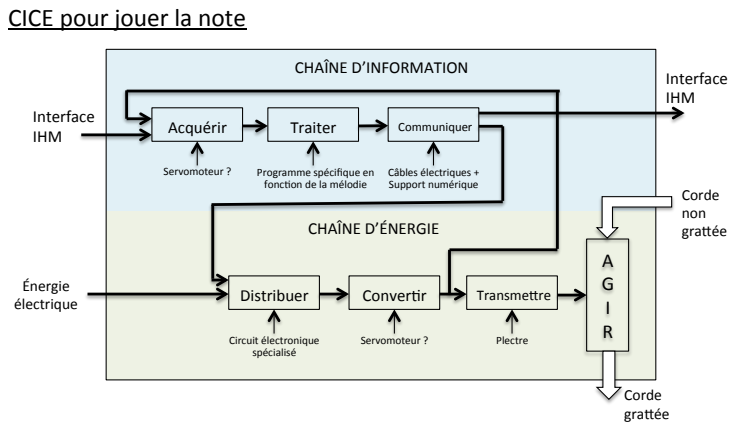
[picture p82: page 2]
Distribuer; Circuit électronique spécialisé; Conver4r; Servomoteur ?; Transme8re; Plectre; non gra8ée; Corde gra8ée; CHAÎNE D’ÉNERGIE; CHAÎNE D’INFORMATION; Énergie électrique; Acquérir; Traiter; Communiquer; Câbles électriques + Support numérique; Interface IHM

CICE pour jouer la note

Programme spécifique en
fonc4on de la mélodie
