Groupe-Mecatronique-Mines-04/Orchestre/Archives/DocumentsGuitarElec/TxEleves/Windchill/Sous-projets/Chaine d'+�nergie et d'information/chaine d'information et d'energie.pdf

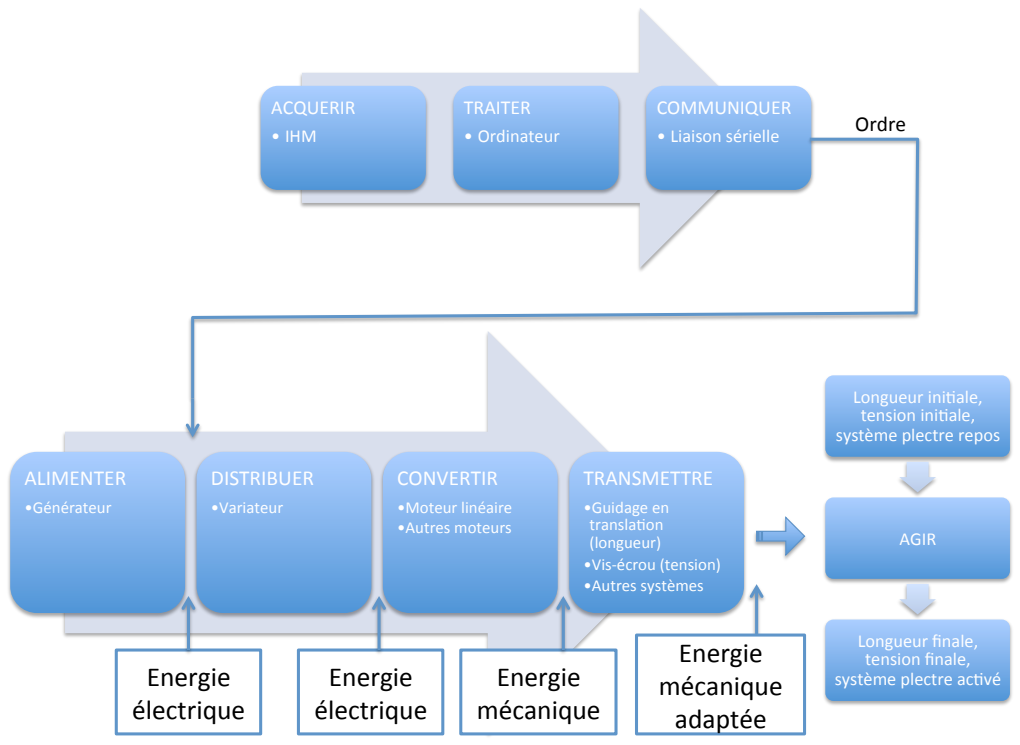
[picture p83: page 1]
ACQUERIR • IHM; TRAITER • Ordinateur; COMMUNIQUER • Liaison; sérielle; ALIMENTER; •Générateur; DISTRIBUER; •Variateur; CONVERTIR; •Moteur; linéaire; •Autres; moteurs; TRANSMETTRE; •Guidage; en translaCon (longueur) •Vis-‐écrou; (tension); systèmes; Ordre; Longueur; iniCale,; tension; système; plectre; repos; AGIR; finale,; Energie; acCvé; électrique; Energie électrique; Energie mécanique; Energie mécanique adaptée
