Groupe-Mecatronique-Mines-04/Orchestre/ardyno/examples/test_motor/test_motor.ino

#include <SoftwareSerial.h>
#include "DynamixelMotor.h"

const uint8_t id=10;
int16_t speed=256;

//DynamixelInterface &interface=*createSerialInterface(Serial);
// Use this if you use a direction pin with 3-state buffer
//DynamixelInterface &interface=*createSerialInterface(Serial, 2);
// Use this if you want a sofware serial interface (communication speed will be limited)
DynamixelInterface &interface=*createSoftSerialInterface(8,9);

DynamixelMotor motor(interface, id);

void setup()
{ 
  delay(100);
  interface.begin(9615);
  delay(100);
  
  motor.init();
  motor.enableTorque();
  
  // reset to middle position
  motor.jointMode();
  motor.speed(speed);
  motor.goalPosition(0x1ff);
  delay(5000);
  motor.wheelMode();
}

void loop() 
{
   //change motion direction every 5 seconds
  motor.speed(speed);
  speed=-speed;
  delay(5000);
}
