Groupe-Mecatronique-Mines-04/Orchestre/(commit log)

2016-10-18 Fichiers de départ groupe précédent
2016-10-25 Archives et doc
    [Micro Planning 2610.xlsx, Micro Planning 2710.xlsx, Planning com m+�catro2.xlsx]
2016-11-02 debut du code Arduino, non fonctionnel
2016-11-08 Code Arduino fonctionnel
2017-01-03 driver servo AX12 de Louis
2017-01-10 Driver servo AX12 et script test fonctionnel
    [controltable.ods]
2017-05-18 flute fonctionnelle
    [controltable.ods]
